quannguyen247/BTMatrix8051_16x16/source/sample.png

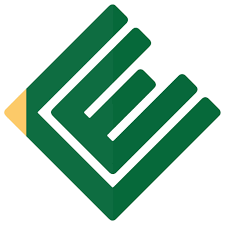
source/sample.png
